thisgradi/cherry_g80_11800/ortho_v2.kicad_sch

## KiCad design ortho_v2.kicad_sch (2024-01-31)

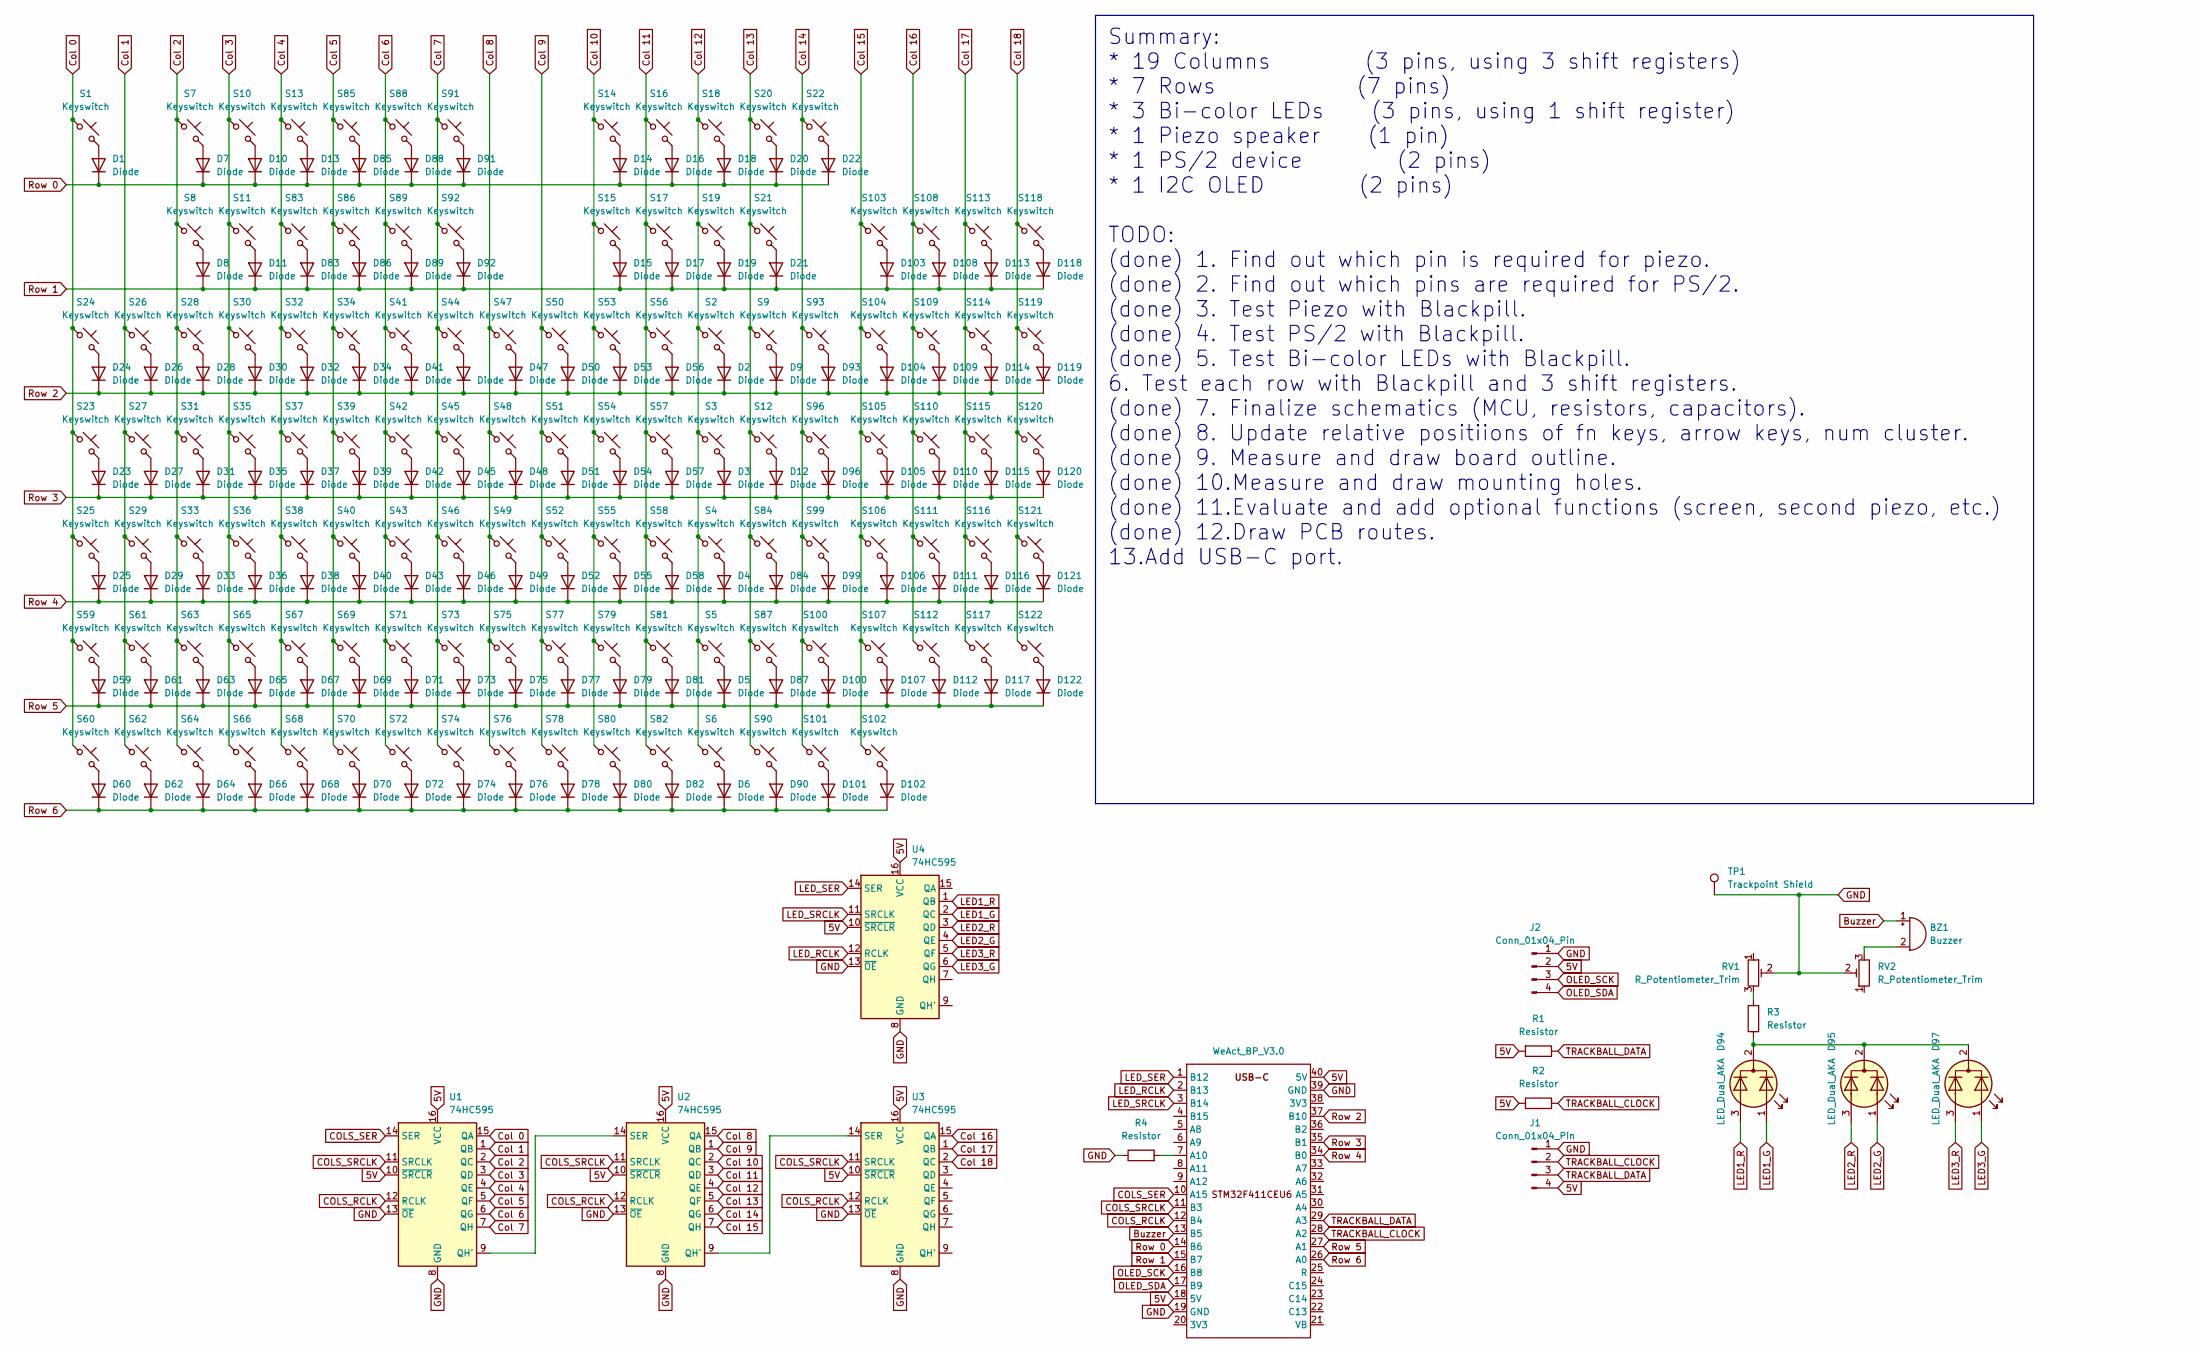
[picture p1: schematic ortho_v2.kicad_sch]

Parts:
BZ1: Buzzer; Buzzer_12x9.5RM7.6
D1, D2, D3, D4, D5, D6, D7, D8, D9, D10, D11, D12, D13, D14, D15, D16, D17, D18, D19, D20, D21, D22, D23, D24, D25, D26, D27, D28, D29, D30, D31, D32, D33, D34, D35, D36, D37, D38, D39, D40, D41, D42, D43, D44, D45, D46, D47, D48, D49, D50, D51, D52, D53, D54, D55, D56, D57, D58, D59, D60, D61, D62, D63, D64, D65, D66, D67, D68, D69, D70, D71, D72, D73, D74, D75, D76, D77, D78, D79, D80, D81, D82, D83, D84, D85, D86, D87, D88, D89, D90, D91, D92, D93, D96, D99, D100, D101, D102, D103, D104, D105, D106, D107, D108, D109, D110, D111, D112, D113, D114, D115, D116, D117, D118, D119, D120, D121, D122: Diode; Diode_DO-35
D94, D95, D97: LED_Dual_AKA; LED_D3.0mm-3
J1, J2: Conn_01x04_Pin; PinHeader_1x04_P2.54mm_Horizontal
R1, R2, R3, R4: Resistor; R_Axial_DIN0207_L6.3mm_D2.5mm_P10.16mm_Horizontal
RV1, RV2: R_Potentiometer_Trim; POT_3296W
S1, S2, S3, S4, S5, S6, S7, S8, S9, S10, S11, S12, S13, S14, S15, S16, S17, S18, S19, S20, S21, S22, S23, S24, S25, S26, S27, S28, S29, S30, S31, S32, S33, S34, S35, S36, S37, S38, S39, S40, S41, S42, S43, S44, S45, S46, S47, S48, S49, S50, S51, S52, S53, S54, S55, S56, S57, S58, S59, S60, S61, S62, S63, S64, S65, S66, S67, S68, S69, S70, S71, S72, S73, S74, S75, S76, S77, S78, S79, S80, S81, S82, S83, S84, S85, S86, S87, S88, S89, S90, S91, S92, S93, S96, S99, S100, S101, S102, S103, S104, S105, S106, S107, S108, S109, S110, S111, S112, S113, S114, S115, S116, S117, S118, S119, S120, S121, S122: Keyswitch; MX_PCB_1.00u
TP1: Trackpoint Shield; TestPoint_Pad_4.0x4.0mm
U1, U2, U3, U4: 74HC595; DIP-16_W7.62mm_Socket
WeAct_BP_V3.0: DIP-40_W15.24mm_Socket

Connections:
5V: J1.4, J2.2, R1.2, R2.1, U1.10 (~SRCLR), U1.16 (VCC), U2.10 (~SRCLR), U2.16 (VCC), U3.10 (~SRCLR), U3.16 (VCC), U4.10 (~SRCLR), U4.16 (VCC), WeAct_BP_V3.0.18 (5V), WeAct_BP_V3.0.40 (5V)
Buzzer: BZ1.1 (-), WeAct_BP_V3.0.13 (B5)
COLS_RCLK: U1.12 (RCLK), U2.12 (RCLK), U3.12 (RCLK), WeAct_BP_V3.0.12 (B4)
COLS_SER: U1.14 (SER), WeAct_BP_V3.0.10 (A15)
COLS_SRCLK: U1.11 (SRCLK), U2.11 (SRCLK), U3.11 (SRCLK), WeAct_BP_V3.0.11 (B3)
Col 0: S1.1, S23.1, S24.1, S25.1, S59.1, S60.1, U1.15 (QA)
Col 1: S26.1, S27.1, S29.1, S61.1, S62.1, U1.1 (QB)
Col 2: S7.1, S8.1, S28.1, S31.1, S33.1, S63.1, S64.1, U1.2 (QC)
Col 3: S10.1, S11.1, S30.1, S35.1, S36.1, S65.1, S66.1, U1.3 (QD)
Col 4: S13.1, S32.1, S37.1, S38.1, S67.1, S68.1, S83.1, U1.4 (QE)
Col 5: S34.1, S39.1, S40.1, S69.1, S70.1, S85.1, S86.1, U1.5 (QF)
Col 6: S41.1, S42.1, S43.1, S71.1, S72.1, S88.1, S89.1, U1.6 (QG)
Col 7: S44.1, S45.1, S46.1, S73.1, S74.1, S91.1, S92.1, U1.7 (QH)
Col 8: S47.1, S48.1, S49.1, S75.1, S76.1, U2.15 (QA)
Col 9: S50.1, S51.1, S52.1, S77.1, S78.1, U2.1 (QB)
Col 10: S14.1, S15.1, S53.1, S54.1, S55.1, S79.1, S80.1, U2.2 (QC)
Col 11: S16.1, S17.1, S56.1, S57.1, S58.1, S81.1, S82.1, U2.3 (QD)
Col 12: S2.1, S3.1, S4.1, S5.1, S6.1, S18.1, S19.1, U2.4 (QE)
Col 13: S9.1, S12.1, S20.1, S21.1, S84.1, S87.1, S90.1, U2.5 (QF)
Col 14: S22.1, S93.1, S96.1, S99.1, S100.1, S101.1, U2.6 (QG)
Col 15: S102.1, S103.1, S104.1, S105.1, S106.1, S107.1, U2.7 (QH)
Col 16: S108.1, S109.1, S110.1, S111.1, S112.1, U3.15 (QA)
Col 17: S113.1, S114.1, S115.1, S116.1, S117.1, U3.1 (QB)
Col 18: S118.1, S119.1, S120.1, S121.1, S122.1, U3.2 (QC)
GND: J1.1, J2.1, R4.1, RV1.2, RV2.2, TP1.1, U1.8 (GND), U1.13 (~OE), U2.8 (GND), U2.13 (~OE), U3.8 (GND), U3.13 (~OE), U4.8 (GND), U4.13 (~OE), WeAct_BP_V3.0.19 (GND), WeAct_BP_V3.0.39 (GND)
LED1_G: D94.1 (A1), U4.2 (QC)
LED1_R: D94.3 (A2), U4.1 (QB)
LED2_G: D95.1 (A1), U4.4 (QE)
LED2_R: D95.3 (A2), U4.3 (QD)
LED3_G: D97.1 (A1), U4.6 (QG)
LED3_R: D97.3 (A2), U4.5 (QF)
LED_RCLK: U4.12 (RCLK), WeAct_BP_V3.0.2 (B13)
LED_SER: U4.14 (SER), WeAct_BP_V3.0.1 (B12)
LED_SRCLK: U4.11 (SRCLK), WeAct_BP_V3.0.3 (B14)
unnamed: BZ1.2 (+), RV2.3
unnamed: D1.2 (A), S1.2
unnamed: D2.2 (A), S2.2
unnamed: D3.2 (A), S3.2
unnamed: D4.2 (A), S4.2
unnamed: D5.2 (A), S5.2
unnamed: D6.2 (A), S6.2
unnamed: D7.2 (A), S7.2
unnamed: D8.2 (A), S8.2
unnamed: D9.2 (A), S9.2
unnamed: D10.2 (A), S10.2
unnamed: D11.2 (A), S11.2
unnamed: D12.2 (A), S12.2
unnamed: D13.2 (A), S13.2
unnamed: D14.2 (A), S14.2
unnamed: D15.2 (A), S15.2
unnamed: D16.2 (A), S16.2
unnamed: D17.2 (A), S17.2
unnamed: D18.2 (A), S18.2
unnamed: D19.2 (A), S19.2
unnamed: D20.2 (A), S20.2
unnamed: D21.2 (A), S21.2
unnamed: D22.2 (A), S22.2
unnamed: D23.2 (A), S23.2
unnamed: D24.2 (A), S24.2
unnamed: D25.2 (A), S25.2
unnamed: D26.2 (A), S26.2
unnamed: D27.2 (A), S27.2
unnamed: D28.2 (A), S28.2
unnamed: D29.2 (A), S29.2
unnamed: D30.2 (A), S30.2
unnamed: D31.2 (A), S31.2
unnamed: D32.2 (A), S32.2
unnamed: D33.2 (A), S33.2
unnamed: D34.2 (A), S34.2
unnamed: D35.2 (A), S35.2
unnamed: D36.2 (A), S36.2
unnamed: D37.2 (A), S37.2
unnamed: D38.2 (A), S38.2
unnamed: D39.2 (A), S39.2
unnamed: D40.2 (A), S40.2
unnamed: D41.2 (A), S41.2
unnamed: D42.2 (A), S42.2
unnamed: D43.2 (A), S43.2
unnamed: D44.2 (A), S44.2
unnamed: D45.2 (A), S45.2
unnamed: D46.2 (A), S46.2
unnamed: D47.2 (A), S47.2
unnamed: D48.2 (A), S48.2
unnamed: D49.2 (A), S49.2
unnamed: D50.2 (A), S50.2
unnamed: D51.2 (A), S51.2
unnamed: D52.2 (A), S52.2
unnamed: D53.2 (A), S53.2
unnamed: D54.2 (A), S54.2
unnamed: D55.2 (A), S55.2
unnamed: D56.2 (A), S56.2
unnamed: D57.2 (A), S57.2
unnamed: D58.2 (A), S58.2
unnamed: D59.2 (A), S59.2
unnamed: D60.2 (A), S60.2
unnamed: D61.2 (A), S61.2
unnamed: D62.2 (A), S62.2
unnamed: D63.2 (A), S63.2
unnamed: D64.2 (A), S64.2
unnamed: D65.2 (A), S65.2
unnamed: D66.2 (A), S66.2
unnamed: D67.2 (A), S67.2
unnamed: D68.2 (A), S68.2
unnamed: D69.2 (A), S69.2
unnamed: D70.2 (A), S70.2
unnamed: D71.2 (A), S71.2
unnamed: D72.2 (A), S72.2
unnamed: D73.2 (A), S73.2
unnamed: D74.2 (A), S74.2
unnamed: D75.2 (A), S75.2
unnamed: D76.2 (A), S76.2
unnamed: D77.2 (A), S77.2
unnamed: D78.2 (A), S78.2
unnamed: D79.2 (A), S79.2
unnamed: D80.2 (A), S80.2
unnamed: D81.2 (A), S81.2
unnamed: D82.2 (A), S82.2
unnamed: D83.2 (A), S83.2
unnamed: D84.2 (A), S84.2
unnamed: D85.2 (A), S85.2
unnamed: D86.2 (A), S86.2
unnamed: D87.2 (A), S87.2
unnamed: D88.2 (A), S88.2
unnamed: D89.2 (A), S89.2
unnamed: D90.2 (A), S90.2
unnamed: D91.2 (A), S91.2
unnamed: D92.2 (A), S92.2
unnamed: D93.2 (A), S93.2
unnamed: D94.2 (K), D95.2 (K), D97.2 (K), R3.1
unnamed: D96.2 (A), S96.2
unnamed: D99.2 (A), S99.2
unnamed: D100.2 (A), S100.2
unnamed: D101.2 (A), S101.2
unnamed: D102.2 (A), S102.2
unnamed: D103.2 (A), S103.2
unnamed: D104.2 (A), S104.2
unnamed: D105.2 (A), S105.2
unnamed: D106.2 (A), S106.2
unnamed: D107.2 (A), S107.2
unnamed: D108.2 (A), S108.2
unnamed: D109.2 (A), S109.2
unnamed: D110.2 (A), S110.2
unnamed: D111.2 (A), S111.2
unnamed: D112.2 (A), S112.2
unnamed: D113.2 (A), S113.2
unnamed: D114.2 (A), S114.2
unnamed: D115.2 (A), S115.2
unnamed: D116.2 (A), S116.2
unnamed: D117.2 (A), S117.2
unnamed: D118.2 (A), S118.2
unnamed: D119.2 (A), S119.2
unnamed: D120.2 (A), S120.2
unnamed: D121.2 (A), S121.2
unnamed: D122.2 (A), S122.2
unnamed: R3.2, RV1.3
unnamed: R4.2, WeAct_BP_V3.0.7 (A10)
unnamed: U1.9 (QH'), U2.14 (SER)
unnamed: U2.9 (QH'), U3.14 (SER)
OLED_SCK: J2.3, WeAct_BP_V3.0.16 (B8)
OLED_SDA: J2.4, WeAct_BP_V3.0.17 (B9)
Row 0: D1.1 (K), D7.1 (K), D10.1 (K), D13.1 (K), D14.1 (K), D16.1 (K), D18.1 (K), D20.1 (K), D22.1 (K), D85.1 (K), D88.1 (K), D91.1 (K), WeAct_BP_V3.0.14 (B6)
Row 1: D8.1 (K), D11.1 (K), D15.1 (K), D17.1 (K), D19.1 (K), D21.1 (K), D83.1 (K), D86.1 (K), D89.1 (K), D92.1 (K), D103.1 (K), D108.1 (K), D113.1 (K), D118.1 (K), WeAct_BP_V3.0.15 (B7)
Row 2: D2.1 (K), D9.1 (K), D24.1 (K), D26.1 (K), D28.1 (K), D30.1 (K), D32.1 (K), D34.1 (K), D41.1 (K), D44.1 (K), D47.1 (K), D50.1 (K), D53.1 (K), D56.1 (K), D93.1 (K), D104.1 (K), D109.1 (K), D114.1 (K), D119.1 (K), WeAct_BP_V3.0.37 (B10)
Row 3: D3.1 (K), D12.1 (K), D23.1 (K), D27.1 (K), D31.1 (K), D35.1 (K), D37.1 (K), D39.1 (K), D42.1 (K), D45.1 (K), D48.1 (K), D51.1 (K), D54.1 (K), D57.1 (K), D96.1 (K), D105.1 (K), D110.1 (K), D115.1 (K), D120.1 (K), WeAct_BP_V3.0.35 (B1)
Row 4: D4.1 (K), D25.1 (K), D29.1 (K), D33.1 (K), D36.1 (K), D38.1 (K), D40.1 (K), D43.1 (K), D46.1 (K), D49.1 (K), D52.1 (K), D55.1 (K), D58.1 (K), D84.1 (K), D99.1 (K), D106.1 (K), D111.1 (K), D116.1 (K), D121.1 (K), WeAct_BP_V3.0.34 (B0)
Row 5: D5.1 (K), D59.1 (K), D61.1 (K), D63.1 (K), D65.1 (K), D67.1 (K), D69.1 (K), D71.1 (K), D73.1 (K), D75.1 (K), D77.1 (K), D79.1 (K), D81.1 (K), D87.1 (K), D100.1 (K), D107.1 (K), D112.1 (K), D117.1 (K), D122.1 (K), WeAct_BP_V3.0.27 (A1)
Row 6: D6.1 (K), D60.1 (K), D62.1 (K), D64.1 (K), D66.1 (K), D68.1 (K), D70.1 (K), D72.1 (K), D74.1 (K), D76.1 (K), D78.1 (K), D80.1 (K), D82.1 (K), D90.1 (K), D101.1 (K), D102.1 (K), WeAct_BP_V3.0.26 (A0)
TRACKBALL_CLOCK: J1.2, R2.2, WeAct_BP_V3.0.28 (A2)
TRACKBALL_DATA: J1.3, R1.1, WeAct_BP_V3.0.29 (A3)

Notes on the sheet:
Summary: * 19 Columns (3 pins, using 3 shift registers) * 7 Rows (7 pins) * 3 Bi-color LEDs (3 pins, using 1 shift register) * 1 Piezo speaker (1 pin) * 1 PS/2 device (2 pins) * 1 I2C OLED (2 pins) TODO: (done) 1. Find out which pin is required for piezo. (done) 2. Find out which pins are required 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
