thisgradi/cherry_g80_11800/(commit log)

2024-01-31 G80_11800 file dump 01/31/2024
    This dump includes:
    * QMK files (LEDs, OLED, PS/2, piezo work OK. Matrix doesn't)
    * KiCad files (rev.0.1, unchanged. Num cluster shifted to the left ~1.5mm)
    [ortho_v2.kicad_sch]
2024-02-02 Update and rename Schematic.md to Schematic.txt
    Schematic file format changed
